nashriveraramirez0520-art/Orbitrail/cad/Orbitrail.step

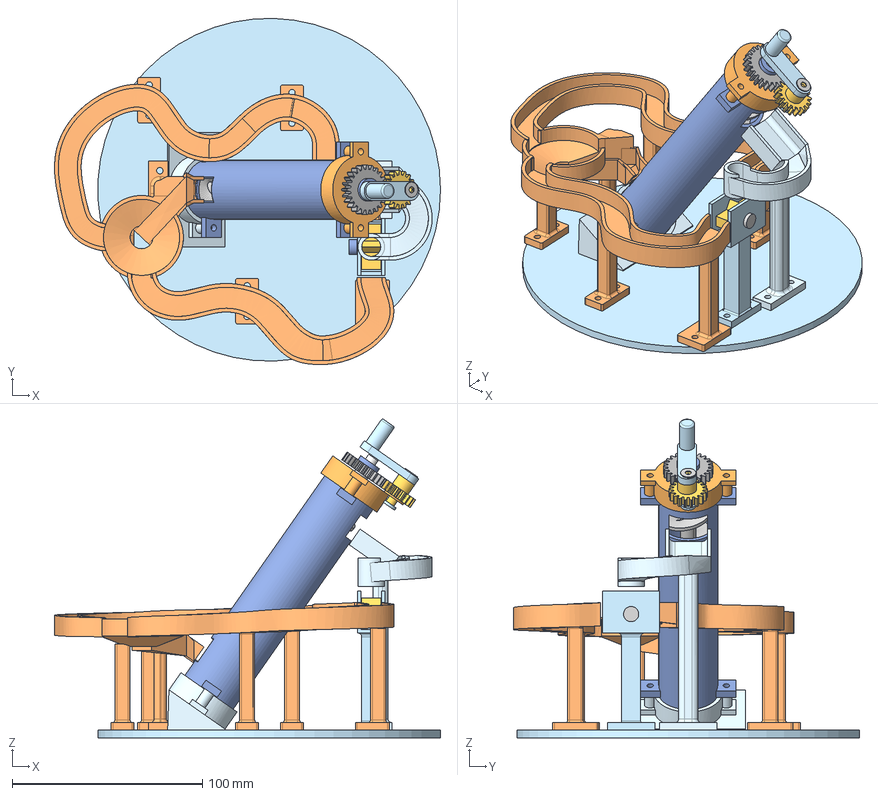
[picture p6: CAD file, 2026-10-18]
cad/Orbitrail.step
202.7 x 181.8 x 167.4 mm
