nashriveraramirez0520-art/Orbitrail/cad/stl/lift-gear.stl

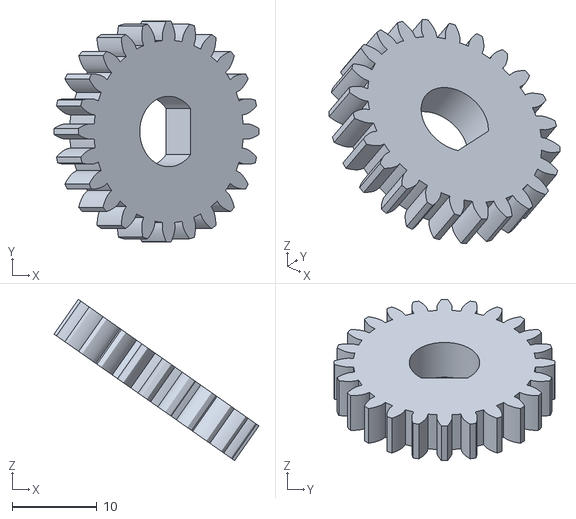
[picture p7: CAD file, 2026-10-26]
cad/stl/lift-gear.stl
24.2 x 26.0 x 19.0
