nashriveraramirez0520-art/Orbitrail/cad/stl/crank-arm.stl

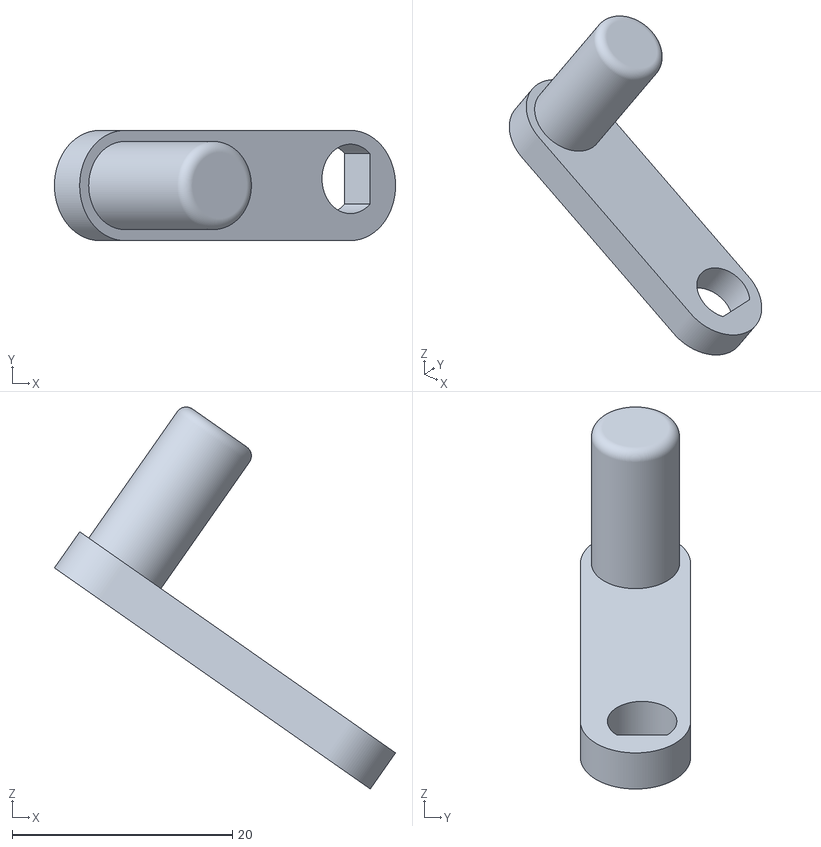
[picture p8: CAD file, 2026-10-26]
cad/stl/crank-arm.stl
31.0 x 10.0 x 34.7
