nashriveraramirez0520-art/Orbitrail/cad/stl/rocker-pin.stl

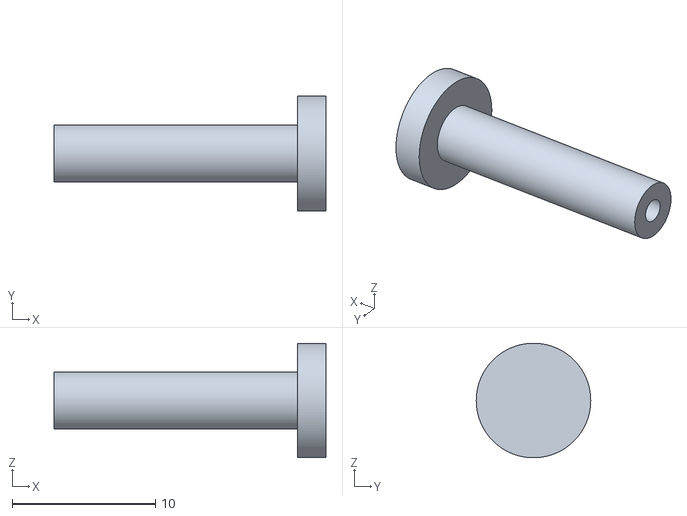
[picture p9: CAD file, 2026-10-26]
cad/stl/rocker-pin.stl
19.0 x 8.00 x 8.00
