nashriveraramirez0520-art/Orbitrail/cad/stl/rocker-pin-cap.stl

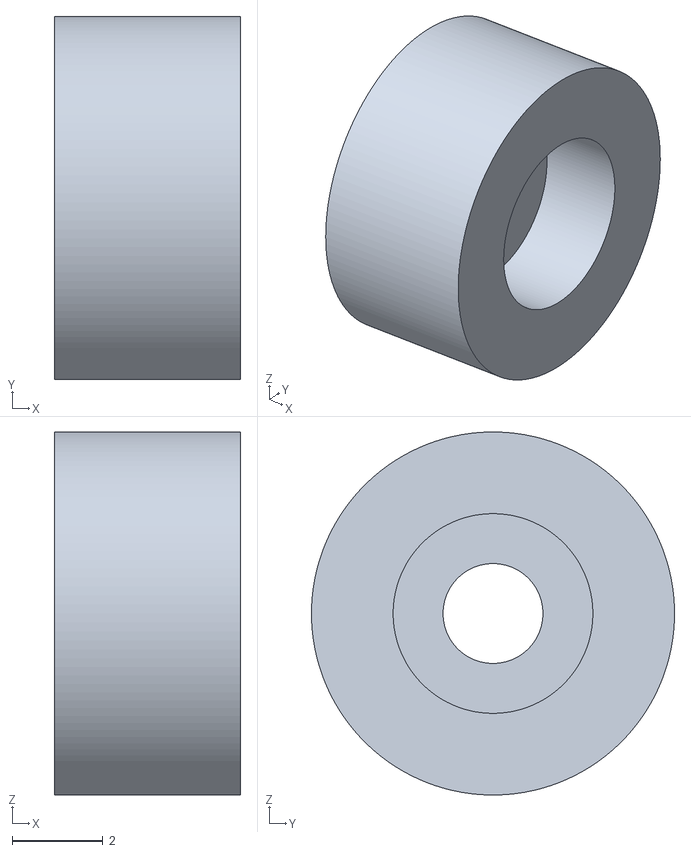
[picture p10: CAD file, 2026-10-26]
cad/stl/rocker-pin-cap.stl
4.10 x 8.00 x 8.00
