nashriveraramirez0520-art/Orbitrail/cad/stl/rocker.stl

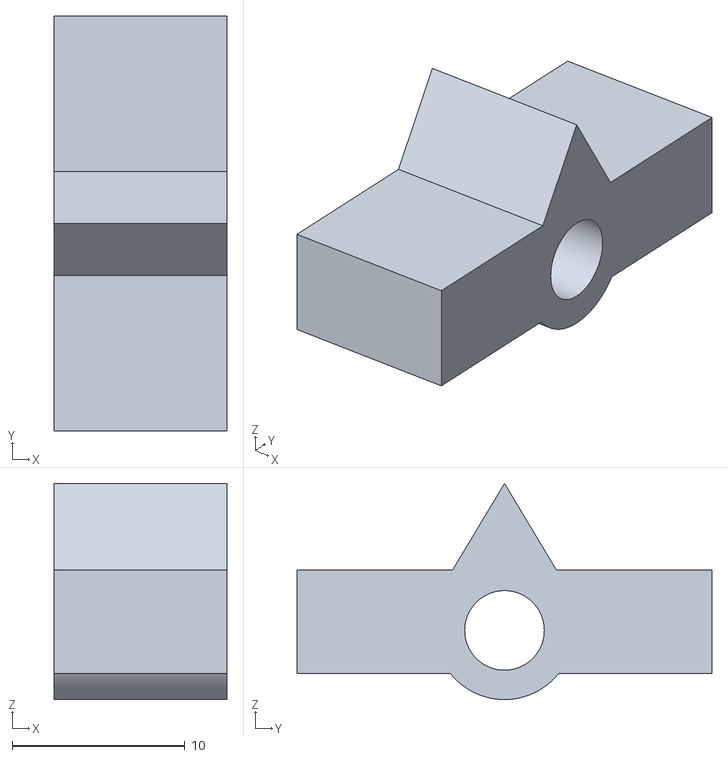
[picture p11: CAD file, 2026-10-26]
cad/stl/rocker.stl
10.0 x 24.0 x 12.5
