nashriveraramirez0520-art/Orbitrail/cad/stl/crank-gear-18t.stl

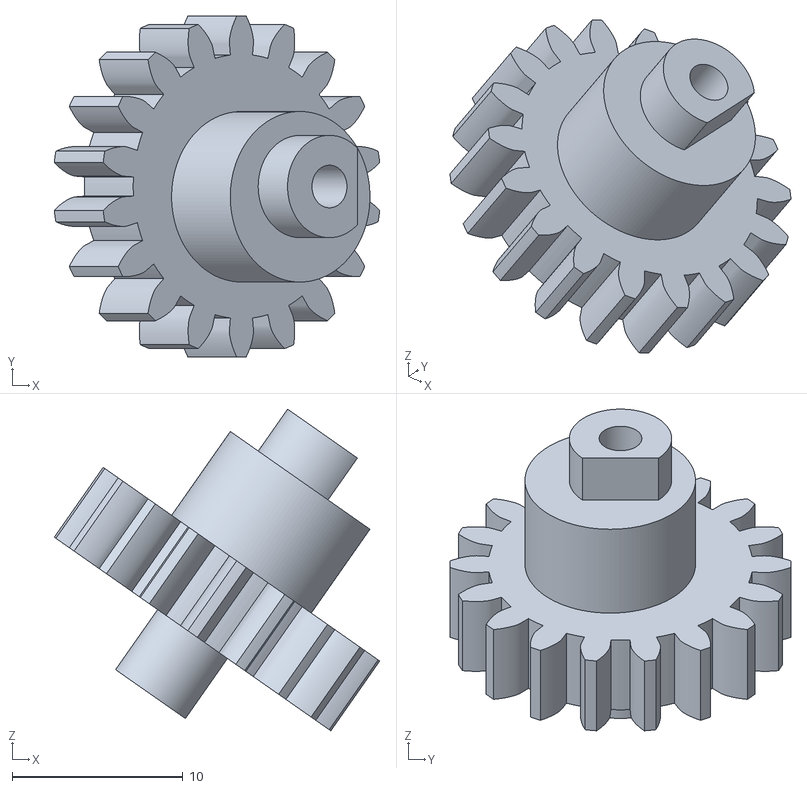
[picture p12: CAD file, 2026-10-26]
cad/stl/crank-gear-18t.stl
19.1 x 20.0 x 18.9
