nashriveraramirez0520-art/Orbitrail/cad/stl/base.stl

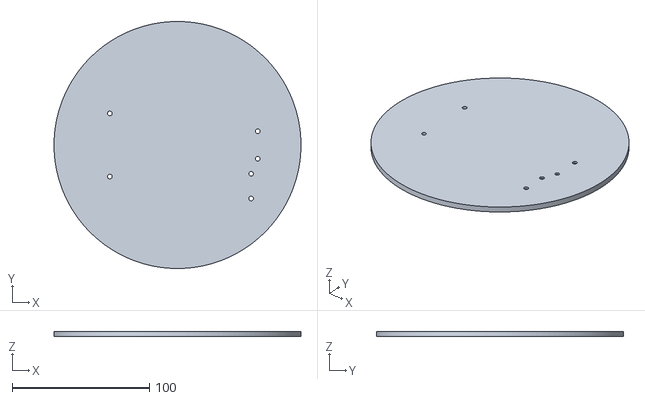
[picture p13: CAD file, 2026-10-26]
cad/stl/base.stl
180.0 x 179.9 x 4.00
