nashriveraramirez0520-art/Orbitrail/cad/stl/crank-retainer.stl

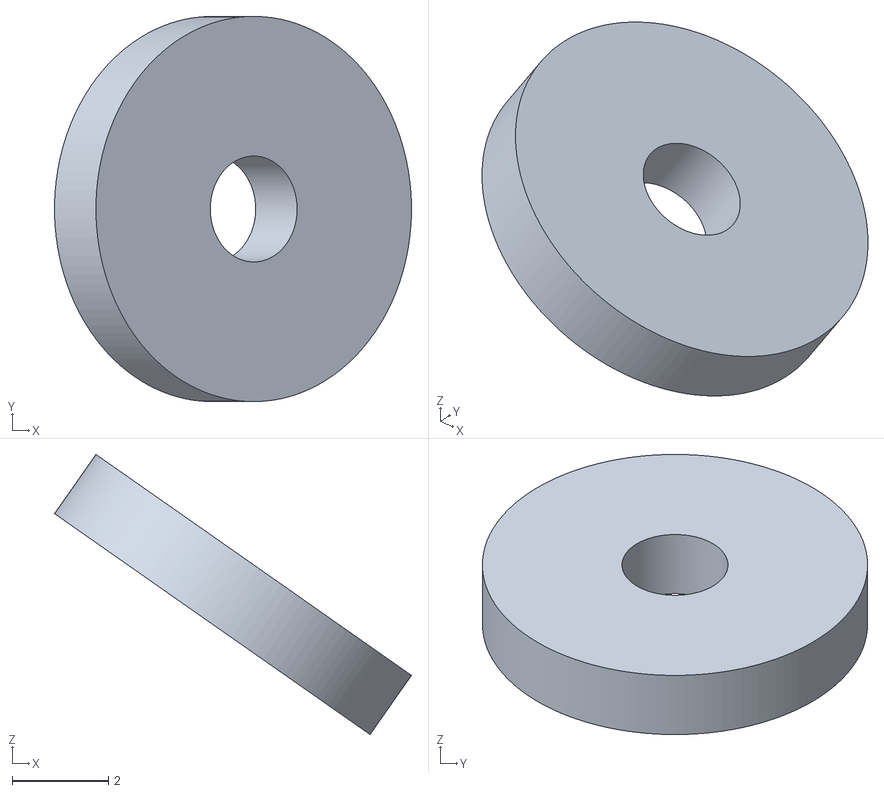
[picture p14: CAD file, 2026-10-26]
cad/stl/crank-retainer.stl
7.41 x 8.00 x 5.82
