nashriveraramirez0520-art/Orbitrail/cad/stl/lower-pedestal.stl

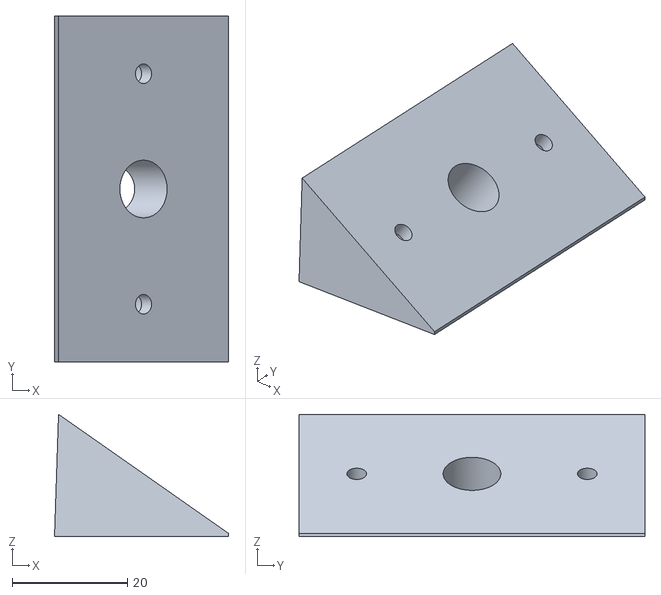
[picture p15: CAD file, 2026-10-26]
cad/stl/lower-pedestal.stl
30.2 x 60.0 x 21.2
