nashriveraramirez0520-art/Orbitrail/cad/stl/smooth-stairs-curves-funnel.stl

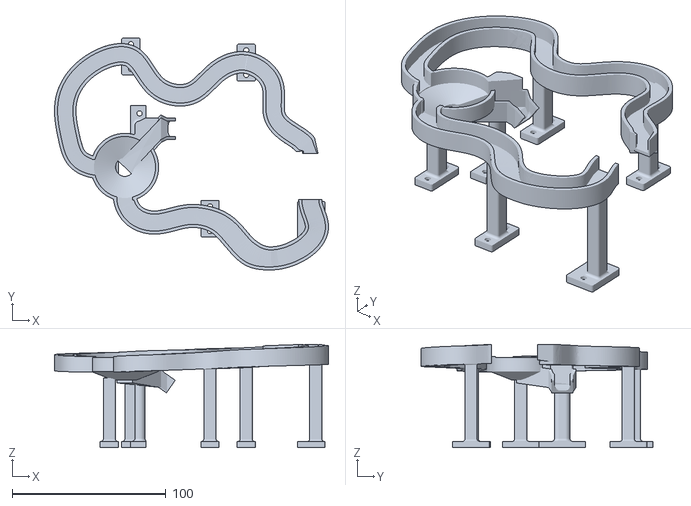
[picture p16: CAD file, 2026-10-26]
cad/stl/smooth-stairs-curves-funnel.stl
178.2 x 150.8 x 67.0
