nashriveraramirez0520-art/Orbitrail/cad/stl/lower-cap.stl

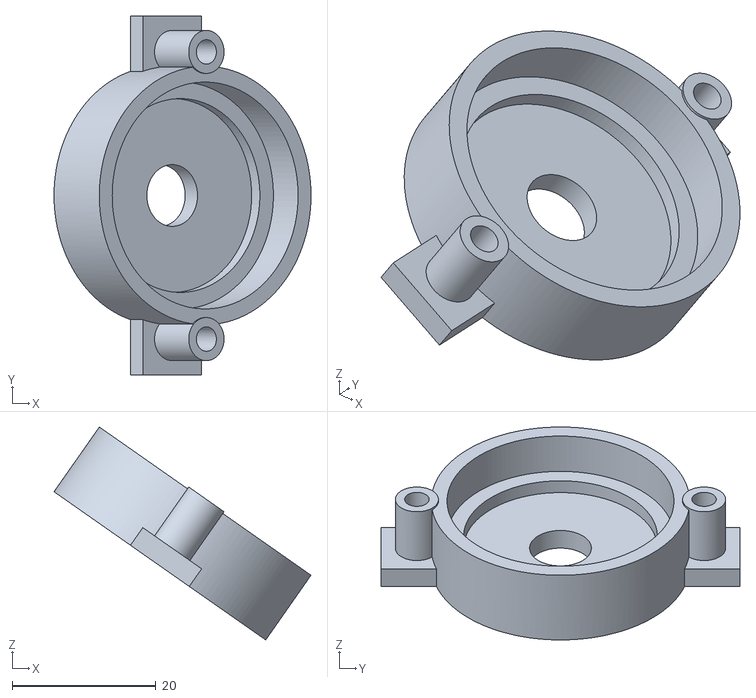
[picture p17: CAD file, 2026-10-26]
cad/stl/lower-cap.stl
35.8 x 50.0 x 29.7
