nashriveraramirez0520-art/Orbitrail/cad/stl/lift-gear-retainer.stl

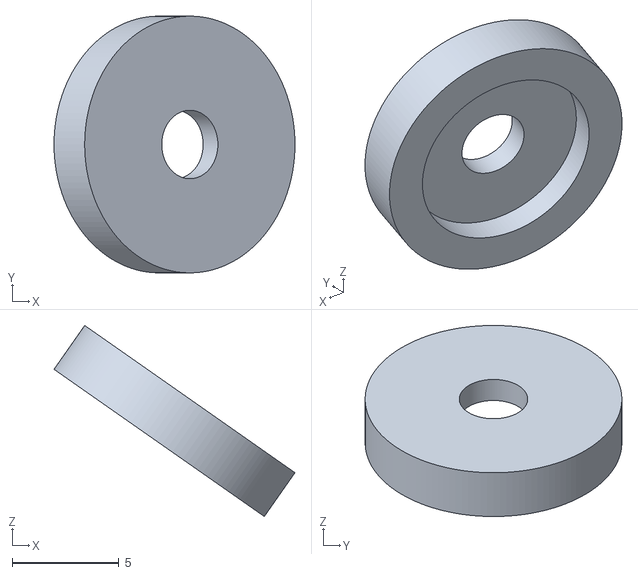
[picture p18: CAD file, 2026-10-26]
cad/stl/lift-gear-retainer.stl
11.3 x 12.0 x 8.93
