nashriveraramirez0520-art/Orbitrail/cad/stl/upper-cap.stl

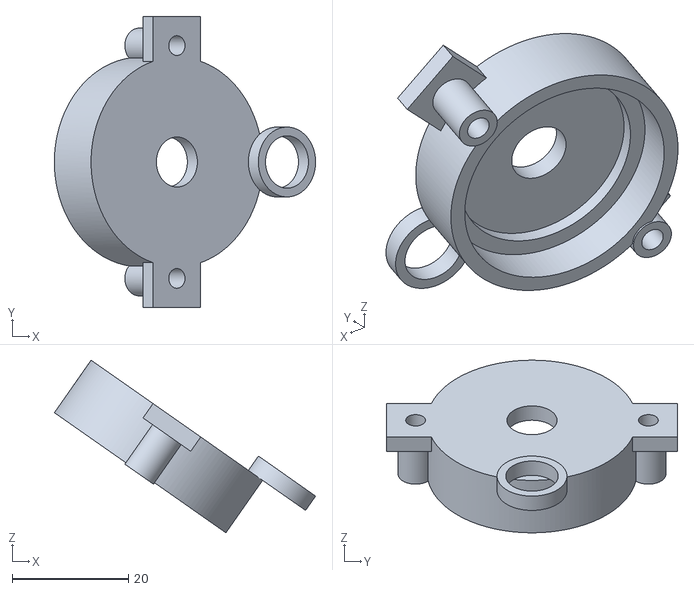
[picture p19: CAD file, 2026-10-26]
cad/stl/upper-cap.stl
44.9 x 50.0 x 29.7
