nashriveraramirez0520-art/Orbitrail/cad/stl/drop-guide.stl

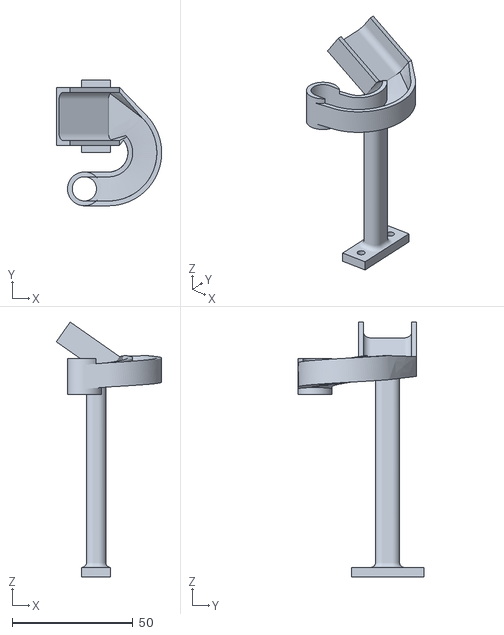
[picture p20: CAD file, 2026-10-26]
cad/stl/drop-guide.stl
43.6 x 52.0 x 105.6
