nashriveraramirez0520-art/Orbitrail/cad/stl/lift-housing.stl

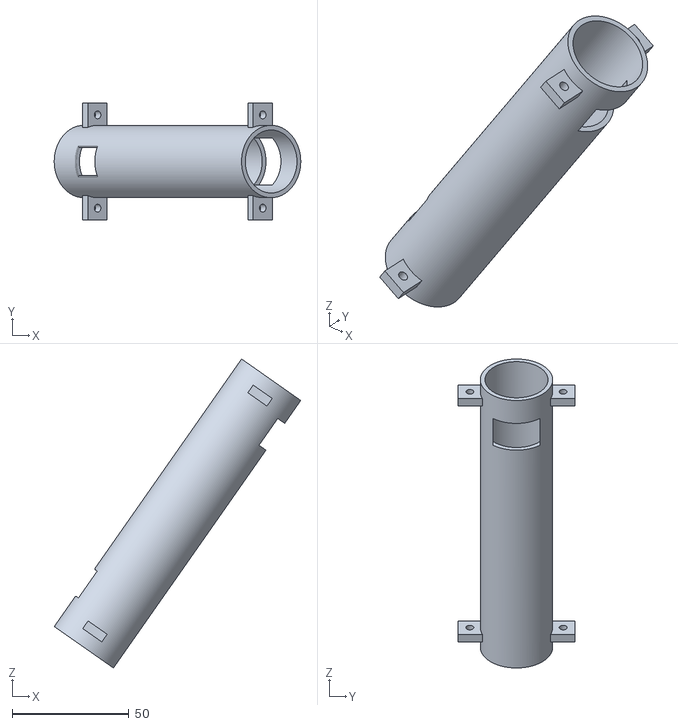
[picture p21: CAD file, 2026-10-26]
cad/stl/lift-housing.stl
105.7 x 50.0 x 132.5
