nashriveraramirez0520-art/Orbitrail/cad/stl/rocker-frame.stl

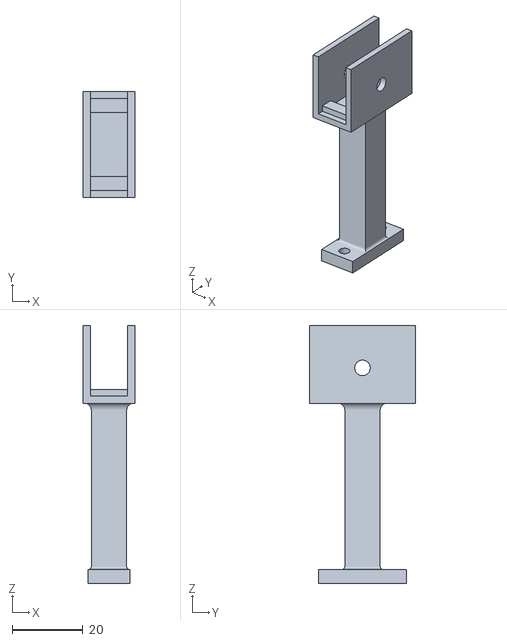
[picture p22: CAD file, 2026-10-26]
cad/stl/rocker-frame.stl
14.6 x 30.0 x 73.0
