nashriveraramirez0520-art/Orbitrail/cad/stl/lift-screw.stl

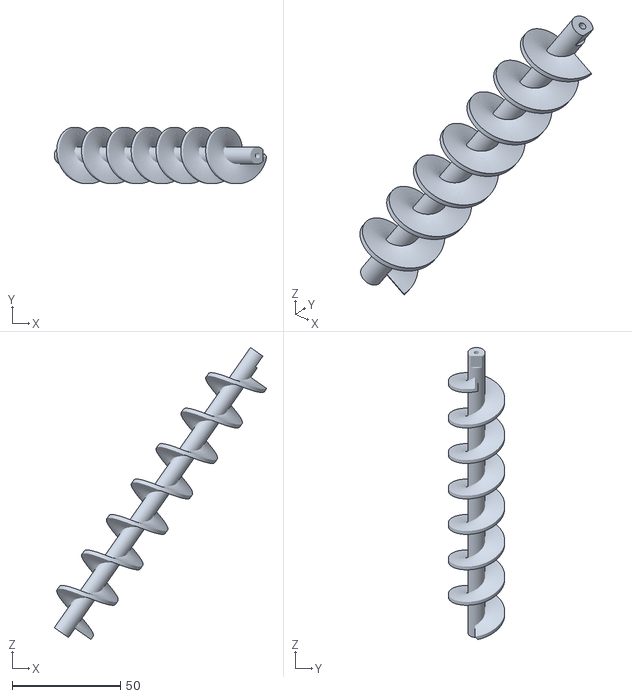
[picture p23: CAD file, 2026-10-26]
cad/stl/lift-screw.stl
98.1 x 26.0 x 134.9
