nashriveraramirez0520-art/Orbitrail/JOURNAL.md

# Orbitrail: devlog

<!-- Generated by Half Life from project cmv4qoh3u0f0t01n0i6g0c1up. Edits here are overwritten on the next sync. -->
<!-- Generated: 2026-10-18T19:59:55.462Z -->

> [!NOTE]
> This devlog is mirrored from [Half Life](https://halflife.hackclub.com) ([open the project](https://halflife.hackclub.com/projects/cmv4qoh3u0f0t01n0i6g0c1up)). Editing it here will not change the platform's copy, and the next sync overwrites this file.

> A custom marble run designed in Onshape for 3D printing, based on the Merbl starter project for Hack Club Half Life. But it differs in the tracs shapes and the main marble lift with a hand cracked elevator!

| Week | Tier | Hours logged | Entries |
| --- | --- | --- | --- |
| Week 2 | Tier 1 | 26.5h | 3 |

## Contents

1. [2026-10-14: Entry 1 — Designing Orbitrail’s Screw Elevator](#2026-10-14-entry-1-designing-orbitrails-screw-elevator)
2. [2026-10-16: Entry 2 — Making Orbitrail Easier to Assemble and Print](#2026-10-16-entry-2-making-orbitrail-easier-to-assemble-and-p)
3. [2026-10-18: Entry 3 — Outlet, Rocker and Complete Return System](#2026-10-18-entry-3-outlet-rocker-and-complete-return-system)

## Design

### 2026-10-14: Entry 1 — Designing Orbitrail’s Screw Elevator

**6.5h**

Entry 1 — Designing Orbitrail’s Screw Elevator
October 13–14, 2026

Today I started developing Orbitrail, my mechanical marble run project for Half Life. I decided to build my own design, with a hand-cranked screw elevator as the central mechanism. The plan is to lift marbles, release them individually, and eventually send them through two different tracks before returning them to the bottom. This session focused on turning that idea into the first elevator components in Onshape.

I began with the overall layout. I modeled a circular base and established the elevator’s position using a layout sketch. The screw is 140 mm long and inclined at 60 degrees to the horizontal. Working from a layout helped me keep the shaft, housing, and end supports aligned instead of positioning each component independently.

The next step was creating the screw. I modeled an 8 mm diameter central shaft and generated a seven-turn helix along its length, giving it a 20 mm pitch. Creating the plane for the flight profile took some troubleshooting: my initial approach produced a “cannot determine rotation axis” error. I resolved that by using a Curve point plane at the helix’s starting point.

On that plane, I sketched a rectangular flight profile measuring 9.5 mm radially by 2 mm thick. I positioned it with 0.5 mm of overlap into the shaft so the swept flight would join the core. Sweeping this profile along the helix produced the screw as a single solid.

I then modeled the stationary housing around it, using a 27 mm inside diameter and a 31 mm outside diameter. The nominal screw diameter is 26 mm, leaving an initial radial clearance of 0.5 mm. These clearances are starting values that will need to be checked with printed parts.

One important design question came up while looking at the inclined screw: would a marble actually move upward, or would it roll back down? I created an 8 mm reference sphere and used section views to examine how it fit between the shaft, flight, and housing. I also used temporary Boolean intersection checks to look for overlapping geometry. An initial marble position intersected the screw, so I adjusted its position and checked again.

These checks helped me understand the available space, but they do not prove that the elevator will work while rotating. The marble’s movement, friction, and behavior at the entrance still need physical testing.

After that, I worked on the end supports. I designed separate lower and upper caps with clearance holes for the shaft, sleeves that locate around the housing, and internal stops that establish the housing’s axial position. I extended the shaft through both ends, including an upper extension for the drive gear.

I added mounting tabs to the caps and housing, aligned holes for M3 fasteners, and hollow standoffs between the tabs. The standoffs provide support across the gap so tightening the fasteners does not simply bend the tabs together. I used section views throughout this process to inspect the sleeves, stops, and shaft clearances. Interpreting those sections carefully mattered because surfaces behind the cutting plane could look like material blocking the shaft.

The final part of the session was the gear drive. I added the MrT Spur Gear custom feature to Onshape and created a 24-tooth gear for the screw and an 18-tooth gear for the future hand crank. Both use module 1, a 20-degree pressure angle, and a 5 mm face width. I placed their centers 21 mm apart using a gear layout sketch.

To transmit torque to the screw, I created a flat on the upper shaft extension, forming a D-shaped end. I projected that profile into a sketch on the driven gear, enlarged it with an initial 0.15 mm outward offset, and cut the matching hole through the gear. I also adjusted the smaller gear’s angular position so its teeth sat between those of the larger gear.

By the end of the session, I had modeled the screw, housing, both end caps, mounting features, reference marble, and the initial gear pair. The next steps are to design the crank shaft and its support, resolve axial retention, refine the gear clearances, and develop the marble inlet and outlet. After that, I can connect the elevator to the rest of the track system.

This session turned the concept into a substantial CAD model, while also showing which parts still need testing rather than relying on appearance alone.

Journal 1 Image 1 1

Journal 1 Image 2 2

Journal 1 Image 3

Journal 1 Image 4

Journal 1 Image 5

Journal 1 Image 6

Journal 1 Image 7

### 2026-10-16: Entry 2 — Making Orbitrail Easier to Assemble and Print

**5h**

Entry 2 — Making Orbitrail Easier to Assemble and Print
October 14–15, 2026

During this session, I continued developing Orbitrail in Onshape. My main focus was turning the screw elevator and its gear drive into a more complete assembly. This meant working on the crank, shaft connections, retaining parts, lower support, and marble inlet. I also spent time checking clearances and reconsidering how the individual parts would be printed and assembled.

I developed the crank mechanism around the smaller gear. I added a shaft beneath the gear and a bearing feature connected to the upper cap. I adjusted the shaft length and added a separate retaining washer underneath it, leaving a small axial clearance between the rotating assembly and the fixed support. I also added a pilot hole for the retaining screw. This gives the crank gear a proposed mounting arrangement, although the fit and friction still need to be tested with printed parts.

Above the gear, I modeled a hub, a crank arm, and a cylindrical handle. One decision I reversed was initially making the crank arm part of the gear. After considering the printing orientation and assembly process, I changed the arm into a separate component. I then designed a D-shaped peg and matching opening so the gear and crank arm can transmit rotation through their shape. I included clearance around the connection and a central pilot hole for a fastening screw.

This connection required some troubleshooting. When creating the D-shaped peg, I initially selected the smaller circular segment instead of the larger D-shaped region. Correcting the selection produced the intended geometry. It was a useful reminder to inspect the resulting solid carefully before continuing with features that depend on it.

I also worked on retaining the larger gear on the elevator shaft. I modeled a separate retainer with an underside recess to clear the shaft tip while allowing the outer rim to rest against the gear. I used section views to inspect the arrangement and added a simplified screw-head reference to check the space beneath the crank arm. The model showed a nominal clearance of 0.5 mm there, so this area will need attention when selecting the actual hardware and checking printed tolerances.

Next, I created a wedge-shaped lower pedestal between the inclined elevator cap and the circular base. Its sloped top follows the cap, while its flat bottom rests on the base. I added clearance for the central shaft, holes for the cap fasteners, and recessed access for their heads. I also designed mounting holes between the pedestal and base, adjusting their positions to provide more separation from the other holes.

Finally, I started the inlet ramp. I cut an opening in the housing and created a separate ramp with a floor and two side walls. I added internal fillets to round the lower corners of the channel. Keeping the ramp separate preserves the option to print it in a suitable orientation and attach it afterward.

I inspected the ramp-to-housing transition using a section view and an 8 mm reference circle. The measured minimum separation between the ramp end and the housing exterior was approximately 0.347 mm. The views also revealed a small step at the entrance, so I worked on aligning the ramp floor with the lower edge of the opening.

The session reinforced how much mechanical design depends on assembly details. Modeling the main shapes was only part of the work; fastener access, clearances, print orientation, and smooth transitions all required additional decisions. Next, I need to finish the inlet mounting, develop the outlet and return tracks, and eventually test a printed section of the screw elevator. The CAD checks help identify geometric problems, but they do not yet confirm that the mechanism will lift marbles reliably.

Journal 2 Image 3

Journal 2 Image 5

Journal 2 Image 6

Journal 2 Image 7

Journal 2 Image 8

Journal 2 Image 9

### 2026-10-18: Entry 3 — Outlet, Rocker and Complete Return System

**15h**

Entry 3 — Outlet, Rocker and Complete Return System

Time spent: approximately 20 hours across October 16–18, estimated from two work sessions with brief breaks.

During these sessions, I worked on extending Orbitrail from the screw elevator into a complete return circuit. The main goals were to guide the marbles out of the elevator, direct them through a supported rocker, and develop two different routes that return them to the inlet.

I continued developing the inlet chute’s support and attachment to the circular base. I worked on the mounting foot, screw holes and surrounding clearances so that the support would hold the chute without obstructing the marble channel.

Next, I worked on the outlet and feed chute. Connecting the inclined outlet ramp to the curved feed channel required several iterations. The floor needed to remain continuous, and the sidewalls needed to guide an 8 mm marble through the change in direction.

The transition was one of the most difficult parts of this session. Several loft attempts produced twisted connections or a self-intersecting body. I worked through the profile selections, reference geometry and corner alignment.

I also worked on the drop guide above the rocker.

I then developed the rocker assembly, including the moving rocker, supporting frame, pivot pin and retaining cap. I adjusted the rocker’s position to provide clearance beneath the feed channel and allow it to tilt toward either exit. I added a dedicated support leg and mounting foot to the frame, giving the mechanism a direct connection to the base.

I also explored a metering mechanism synchronized with the crank. Its proposed shaft position interfered with the inlet ramp, so I removed that approach from the current design and concentrated on completing the return circuit.

For the return section, I wanted the two sides to provide different experiences rather than follow nearly identical curves. I specified a longer serpentine route with three descending steps and a separate curved route with a small launch feature and an expanded receiving section. The receiving area includes a lower tray to collect a marble that arrives without enough speed to clear the drop.

I chose a shared funnel to collect marbles from both routes before returning them to the elevator. The funnel connects to the existing inlet ramp through a guarded spout and tapered transition. This keeps the return section connected to the inlet geometry already developed.

Reviewing the initial layout revealed a collision between the funnel support and the original inlet support. I revised the support placement to separate their mounting feet. The updated layout leaves approximately 7.6 mm between the funnel foot and the original inlet foot.

I also revised the tracks’ appearance and construction. The earlier surfaces showed too many divisions between short sections. I changed the layout to use smooth, continuous curves, expanded the serpentines beyond the edge of the base, and retained distinct changes in level only where needed for the steps and launch.

The revised supports include rounded post and foot corners, 1.5 mm fillets at the post-to-foot joints, and additional 0.8 mm fillets at the channel-support connections. Their mounting holes continue through the base, with underside recesses for the nuts.

The geometry checks covered solid validity, interference with fixed components, sampled clearance for 8 mm marbles, and rocker positions at −18°, 0° and +18°. A small interference at the spout-to-inlet connection led to a wider tapered adapter.

By the end of these sessions, the CAD included the supported rocker, two distinct return routes, a common funnel and a continuous connection back to the inlet. Physical testing remains necessary to evaluate rolling speed, the stepped section, the launch and reliable marble transfer throughout the circuit.

Final Orbitrail

Journal 4 Image 1

Journal 4 Image 2

Journal 4 Image 3

Journal 4 Image 4

Journal 4 Image 5

Journal 4 Image 6

Journal 4 Image 7

Journal 4 Image 8

Journal 4 Image 9

Journal 4 Image 10

Journal 4 Image 11

Journal 4 Image 12

Journal 4 Image 13

Journal 4 Image 14

Journal 4 Image 15
