nashriveraramirez0520-art/Orbitrail/(commit log)

2026-10-16 Sync Orbitrail from Half Life
    [BOM.csv]
2026-10-18 Document Orbitrail design and add final CAD overview
2026-10-18 Add CAD detail gallery and organize STEP download
    [Orbitrail.step]
2026-10-26 Add 17 individual STL exports, mesh checks, and printing documentation
    [base.stl, crank-arm.stl, crank-gear-18t.stl, crank-retainer.stl, drop-guide.stl, lift-gear-retainer.stl, lift-gear.stl, lift-housing.stl]
2026-10-26 Document no-funding materials BOM, PLA allowance, and pending hardware selection
    [BOM.csv]
2026-10-26 Include complete bill of materials directly in README
